HotCat/Jaguar/docs/Jaguar-SMD-Side.png

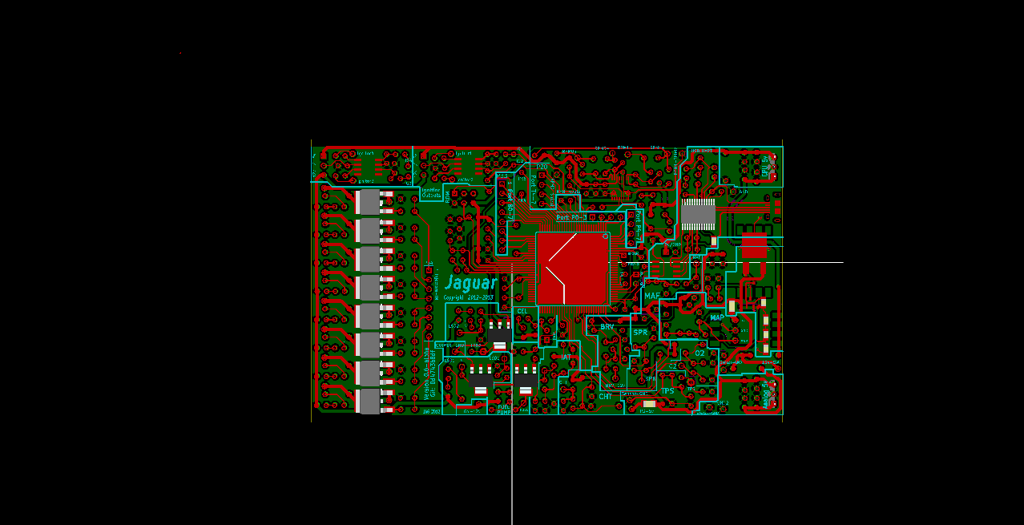
docs/Jaguar-SMD-Side.png
