HotCat/Jaguar/docs/Jaguar-TH-Side.png

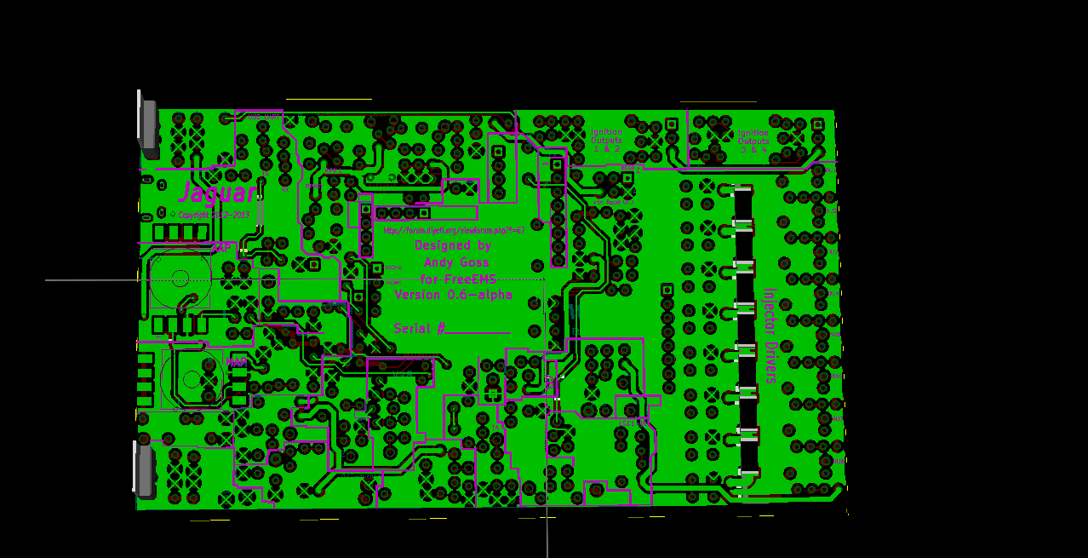
docs/Jaguar-TH-Side.png
