HotCat/Jaguar/docs/MOSFET-GND-Idea.png

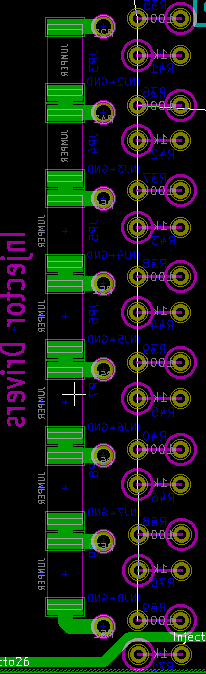
docs/MOSFET-GND-Idea.png
