HotCat/Jaguar/docs/Jaguar.ods

QTY | Reference | Value | Type | Information | To Order | CTM QTY | Manufacturer | Model# | Digikey P/N | Each | Order AMT | CTM | Note
 | Capacitors |  |  |  | 4
4 | C12,13,47,48 | 10uF | TANTALUM 10UF 35V 10% RADIAL, 0.098” LS | Tantalum | 16 | 4 | AVX Corporation | TAP106K035SCS | 478-1842-ND (http://www.digikey.com/product-detail/en/TAP106K035SCS/478-1842-ND/563945) | $1.62 | $25.92 | $6.48
13 | C1,2,3,4,5,8,20,27,37,38,44,51,55 | 0.22uF | CERAMIC 0.22UF 50V 10% RADIAL,X7R 0.098 LS | X7R | 52 | 13 | Kemet | C320C224K5R5TA | 399-4288-ND | $0.46 | $23.87 | $5.97
17 | C6,14,15,16,17,22,26,28,29,32,33,34,35,39,41,49,54 | 0.1uF / 100nF | CERAMIC 0.1UF 50V 10% RADIAL, 0.100” LS | X7R | 68 | 17 | Kemet | C320C104M1U5TA | 399-4264-ND | $0.22 | $15.23 | $3.81
1 | C7 | 6.8nF | CERAMIC 0.068UF 50V 5% RADIAL, 0.098” LS | C0G,NP0 | 4 | 1 | TDK Corportation | FK16C0G1H683J | 445-8330-ND | $0.76 | $3.04 | $0.76
1 | C9 | 680pF | CERAMIC 680PF 100V 5% RADIAL, 0.100” LS | C0G,NP0 | 4 | 1 | Kemet | C315C681J1G5TA | 399-4191-ND | $0.47 | $1.88 | $0.47
2 | C10,11 | 20pF | CERAMIC 20PF 100V 5% RADIAL, 0.100” LS | C0G,NP0 | 8 | 2 | AVX Corporation | SR151A200JAR | 478-7724-ND | $0.46 | $3.68 | $0.92
2 | C18,19 | 47uF | TANTALUM 47UF 10V 10% RADIAL, 0.100” LS | Tantalum | 8 | 2 | AVX Corporation | TAP476K010SCS | 478-1910-ND (http://search.digikey.com/us/en/products/TAP476K010SCS/478-1910-ND/564013) | $1.65 | $13.20 | $3.30
2 | C21,56 | 0.33uF | CERAMIC 0.33UF 50V 10% RADIAL, 0.100” LS | X7R | 8 | 2 | TDK Corporation | FK14X7R1H334K | 445-5312-ND (http://search.digikey.com/us/en/products/FK14X7R1H334K/445-5312-ND/2256792) | $0.38 | $3.04 | $0.76
3 | C23,42,53 | 0.01uF | CERAMIC 10000PF 50V 10% RADIAL, 0.100” LS | X7R | 12 | 3 | Kemet | C315C103K5R5TA | 399-4148-ND (http://www.digikey.com/product-detail/en/C315C103K5R5TA/399-4148-ND/817924) | $0.31 | $3.72 | $0.93
2 | C24,25 | 1nF | CERAMIC 1000PF 100V 10% RADIAL, 0.100” LS | X7R | 8 | 2 | Kemet | C315C102K1R5TA | 399-4144-ND (http://www.digikey.com/product-detail/en/C315C102K1R5TA/399-4144-ND/817920) | $0.32 | $2.56 | $0.64
6 | C30,31,36,43,52,57 | 1uF | CERAMIC 1UF 25V 10% RADIAL, 0.100” LS | X7R | 24 | 6 | Kemet | C315C105K3R5TA | 399-9714-ND | $0.79 | $18.96 | $4.74
1 | C40 | 4.7uF | TANTALUM 4.7UF 10V 10% RADIAL, 0.098” LS | Tantalum | 4 | 1 | AVX Corporation | TAP475K010SCS | 478-1903-ND (http://search.digikey.com/us/en/products/TAP475K010SCS/478-1903-ND/564006) | $0.63 | $2.52 | $0.63
 | Diodes/LEDs
1 | D1 (CEL) | LED-Yellow | LED SS 3MM 588NM YELLOW DIFF | 3mm-LED | 4 | 1 | Kingbright Corp | WP132XYD | 754-1212-ND (http://search.digikey.com/us/en/products/WP132XYD/754-1212-ND/1747611) | $0.15 | $0.60 | $0.15
1 | D2 | 5.6v 1w | DIODE ZENER 5.6V 3W AXIAL | DO-41 | 1 | 1 | ON Semiconductor | 1N5919BG | 1N5919BGOS-ND | $0.34 | $0.34 | $0.34
4 | D4,5,33,34 | LED-Green | LED SS 3MM 568NM GREEN DIFF | 3mm-LED | 16 | 4 | Kingbright Corp | WP132XGD | 754-1210-ND (http://search.digikey.com/us/en/products/WP132XGD/754-1210-ND/1747609) | $0.14 | $2.24 | $0.56
18 | D6,7,8,9,10,11,12,13,14,15,16,17,43,44,45,46,47,48 | 1N5818-TP | DIODE SCHOTTKY 1A 30V DO41 | DO-41 | 72 | 18 | Micro Commercial Co | 1N5818-TP | 1N5818-TPCT-ND (http://search.digikey.com/us/en/products/1N5818-TP/1N5818-TPCT-ND/950587) | $0.30 | $21.60 | $5.40
11 | D18,19,20,21,22,23,30,35,36,39,41 | LED-Red | LED SS 3MM 625NM RED DIFF | 3mm-LED | 44 | 11 | Kingbright Corp | WP132XID | 754-1211-ND (http://search.digikey.com/us/en/products/WP132XID/754-1211-ND/1747610) | $0.10 | $4.58 | $1.14
7 | D24,25,26,27,28,29,31,37,38,40,42 | 1N4148TA | DIODE SS FAST 100V 200MA DO35 | DO-35 | 28 | 7 | Fairchild Semiconductor | 1N4148TA | 1N4148TACT-ND (http://search.digikey.com/us/en/products/1N4148TA/1N4148TACT-ND/1532747) | $0.06 | $1.62 | $0.41
 | Connectors/Jacks
1 | J1 | USB-B micro | CONN USB MICRO B RECPT SMT R/A |  | 4 | 1 | FCI | 10118194-0001LF | 609-4618-1-ND | $0.43 | $1.73 | $0.43
1 | PLUG | TE Connectivity Plug | Automotive Connectors 35 POS AMP SEAL PLUG | Mouser | 0 | 1 | TE Connectivity/AMP | 1-776231-2 | 1-776231-2 (http://www.mouser.com/ProductDetail/TE-Connectivity-AMP/1-776231-2/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) | $14.00 | $0.00 | $14.00
1 | J3 | TE Connectivity Header | Automotive Connectors 35P AMPSEAL HDR ASSM NAT | Mouser | 0 | 1 | TE Connectivity/AMP | 1-7766163-2 | 1-776163-2 (http://www.mouser.com/ProductDetail/TE-Connectivity-AMP/1-776163-2/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) | $11.46 | $0.00 | $11.46
40 | Contacts for PLUG | TE Connectivity Contacts | Automotive Connectors AMPSEAL CONTACT | Mouser | 0 | 40 | TE Connectivity/AMP | 770854-3 | 770854-3 (http://www.mouser.com/ProductDetail/TE-Connectivity/770854-3/?qs=VZ9FDhhp7Snbed9QfbsDdg%3D%3D) | $0.68 | $0.00 | $27.20
10 | Seal Plug for Used Positions | TE Connectivity Seal Plug | AMPSEAL Accessory: SEAL PLUG | Mouser | 0 | 10 | TE Connectivity/AMP | 770678-1 | 770678-1 (http://www.mouser.com/ProductDetail/TE-Connectivity/770678-1/?qs=bVE8zYB%2Fq2c7eY42IkyCvQ%3D%3D) | $0.22 | $0.00 | $2.20
1 | MOV1 | Surge Protection | SURGE ABSORBER 14MM 22V 1000A ZNR | Disc 14mm | 4 | 1 | Panasonic - ECG | ERZ-V14D220 | P7307-ND (http://search.digikey.com/us/en/products/ERZ-V14D220/P7307-ND/227567) | $0.72 | $2.88 | $0.72
2 | F1,F2 | 8v/0.5A Polyfuse | PTC RESTTBLE 0.50A 8V CHIP 1206 | 1206 SMD | 8 | 2 | Bel Fuse Inc | 0ZCA0050FF2G | 507-1480-1-ND | $0.20 | $1.60 | $0.40
1 | L1 | 40 | Ferrite 1.5A 40 Ohm 0805 SMD | 0805 SMD | 4 | 1 | Laird-Signal Integrity Products | MI0805K400R-10 | 240-2389-1-ND | $0.10 | $0.40 | $0.10
2 | JP3,4,5,6,7,8,9 | Jumper | RES 0.0 OHM 1.5W JUMP 2512 SMD | 2512 SMD | 7 | 7 | Vishay Dale | CRCW25120000Z0EGHP | 541-0.0RBCT-ND | $1.58 | $11.07 | $3.16
 | Pin Headers
1 | Load1,P20,P21,P33,P34,JP1,JP2,JP10,JP11,JP16,PP1,PP2 | 0.100 Pin Header | CONN HEADER 50POS .100" SINGLE GOLD |  | 0 | 1 | Samtec Inc | TSW-150-07-L-S | SAM1031-50-ND (http://search.digikey.com/us/en/products/TSW-150-07-L-S/SAM1031-50-ND/1101377) | $3.11 | $0.00 | $3.11
1 | BDM 3x2 0.100” Pin Header | Two Row 0.100 Pin Header | CONN HEADER 34POS .100" DUAL GOLD |  | 0 | 1 | Samtec Inc | TSW-117-07-L-D | TSW-117-07-L-D-ND (http://search.digikey.com/us/en/products/TSW-117-07-L-D/TSW-117-07-L-D-ND/2796113) | $2.13 | $0.00 | $2.13
 | MOSFETs
8 | Q1,2,3,4,5,6,7,8 | VND7NV04 | MOSFET N-CH 40V 6A VND7NV04 60mOhm | DPAK | 0 | 8 | STMicroelectronics | VND7NV04 | 497-2669-5-ND (http://search.digikey.com/us/en/products/VND7NV04/497-2669-5-ND/603694) | $1.71 | $0.00 | $13.68
3 | Q9,10,11 | VNN7NV0413TR | MOSFET N-CH 40V 6A VNN7NV0413TR 60mOhm | SOT-223 | 0 | 3 | STMicroelectronics | VNN7NV0413TR | 497-2519-1-ND (http://search.digikey.com/us/en/products/VNN7NV0413TR/497-2519-1-ND/603901) | $1.71 | $0.00 | $5.13
1 | Q12 | KSH127TF | TRANSISTOR PNP 100V 8A DPAK | DPAK | 4 | 1 | Fairchild Semiconductor | KSH127TF | KSH127TFCT-ND | $0.61 | $2.44 | $0.61
 | Resistors
7 | R1,2,3,4,5,11,12 | 10k | RES 10.0K OHM 1/4W 1% METAL FILM |  | 28 | 7 | Yageo | MFR-25FBF-10K0 | 10.0KXBK-ND (http://search.digikey.com/us/en/products/MFR-25FBF-10K0/10.0KXBK-ND/13219) | $0.08 | $2.30 | $0.57
4 | R16,17,18,19 | 10k | RES 10.0K OHM 1/2W 1% METAL FILM | If using VR inputs | 16 | 4 | Vishay/BC Components | SFR16S0001002FR500 | PPC10.0KXCT-ND (http://search.digikey.com/us/en/products/SFR16S0001002FR500/PPC10.0KXCT-ND/594695) | $0.23 | $3.68 | $0.92 | Only purchase if using VR inputs
1 | R6 | 3.3k | RES 3.3K OHM 1/4W 0.1% AXIAL |  | 4 | 1 | Yageo | MFP-25BRD52-3K3 | 3.3KADCT-ND | $0.55 | $2.20 | $0.55
29 | R7,13,16,17,18,19,21,22,41,42,43,44,45,46,54,70,71,74,77,78,80,81,83,84,87,88,95,104,105 | 1k | RES 1.00K OHM 1/4W 1% METAL FILM |  | 116 | 29 | Yageo | MFR-25FBF-1K00 | 1.00KXBK-ND (http://search.digikey.com/us/en/products/MFR-25FBF-1K00/1.00KXBK-ND/13011) | $0.06 | $6.59 | $1.65
15 | R8,9,10,47,48,49,50,51,52,53,55,66,67,72,75 | 2.4k | RES METAL FILM 2.40K OHM 1/4W 1% |  | 60 | 15 | Stackpole Electronics Inc | RNMF14FTC2K40 | S2.4KCACT-ND (http://search.digikey.com/us/en/products/RNMF14FTC2K40/S2.4KCACT-ND/2617482) | $0.10 | $5.70 | $1.43
9 | R26,27,28,32,33,34,57,58,82 | 470 | RES METAL FILM 1/4W 470 OHM 1% AXIAL |  | 36 | 9 | Stackpole Electronics Inc | RNF14FTD470R | RNF14FTD470RCT-ND | $0.11 | $3.78 | $0.95
2 | R20,23 | 5.1k | RES 5.1K OHM 2W 5% AXIAL | Not Needed for Hall | 8 | 2 | Yageo | FMP200JR-52-5K1 | 5.1KZCT-ND | $0.20 | $1.60 | $0.40 | Only purchase if using VR inputs
3 | R24,25,31 | For GM sensors | 2.49k | RES 2.49K OHM 0.25W 0.1% METAL FILM | For GM Sensors | 12 | 3 | TT Electronics/Welwyn | RC55Y-2K49BI | 985-1047-1-ND (http://search.digikey.com/us/en/products/RC55Y-2K49BI/985-1047-1-ND/2401912) | $1.92 | $23.04 | $5.76 | Only purchase if using GM Sensors
0 | R24,25,31 | For most sensors | 2.43k | RES 2.43K OHM 0.25W 0.1% METAL FILM | For Most Sensors | 0 | 0 | TT Electronics/Welwyn | RC55Y-2K43BI | 985-1046-1-ND (http://search.digikey.com/us/en/products/RC55Y-2K43BI/985-1046-1-ND/2401911) | $1.29 | $0.00 | $0.00 | Good compromise for most Sensors
0 | R24,25,31 | For Ford sensors | 27.4k | RES 27.4K OHM 0.25W 0.1% METAL FILM AXL | For Ford Sensors | 0 | 0 | TT Electronics/Welwyn | RC55Y-27K4BI | 985-1069-1-ND (http://search.digikey.com/us/en/products/RC55Y-27K4BI/985-1069-1-ND/2401934) | $1.29 | $0.00 | $0.00 | Only purchase if using Ford Sensors
0 | R24,25,31 | For MOPAR sensors | 9.1k | RES 9.1K OHM 1/4W 0.1% METAL FILM AXL | For MOPAR Sensors | 0 | 0 | Yageo | MFP-25BRD52-9K1 | 9.1KADCT-ND (http://search.digikey.com/us/en/products/MFP-25BRD52-9K1/9.1KADCT-ND/2059152) | $0.44 | $0.00 | $0.00 | Only purchase if using Mopar Sensors
1 | R29 | 3.9k | RES 3.9K OHM 1/4W 0.1% METAL FILM AXL |  | 4 | 1 | Yageo | MFP-25BRD52-3K9 | 3.9KADCT-ND (http://search.digikey.com/us/en/products/MFP-25BRD52-3K9/3.9KADCT-ND/2059137) | $0.55 | $2.20 | $0.55
1 | R30 | 1.0k | RES 1K OHM 1/4W 0.1% METAL FILM AXL |  | 4 | 1 | Yageo | MFP-25BRD52-1K | 1KADCT-ND (http://search.digikey.com/us/en/products/MFP-25BRD52-1K/1KADCT-ND/2059121) | $0.55 | $2.20 | $0.55
15 | R35,36,37,38,39,40,63,68,69,73,76,89,90,102,103 | 100k | RES 100K OHM 1/4W 1% METAL FILM |  | 60 | 15 | Yageo | MFR-25FBF-100K | 100KXBK-ND (http://search.digikey.com/us/en/products/MFR-25FBF-100K/100KXBK-ND/13473) | $0.06 | $3.41 | $0.85
4 | R91,92,100,101 | 160 | RES 160 OHM 2W 1% AXIAL |  | 16 | 4 | Yageo | FMP200FRF52-160R | 160YCT-ND | $0.27 | $4.32 | $1.08
2 | R106,107 | 10k | RES 10K OHM 1/8W 0.1% 0805 SMD | 0805 SMD | 8 | 2 | Bourns Inc | CRT0805-BY-1002ELF | CRT0805-BY-1002ELFCT-ND | $0.51 | $4.08 | $1.02
1 | R108 | 330 | RES 330 OHM 1/8W 0.1% 0805 SMD | 0805 SMD | 4 | 1 | Panasonic Electronic Components | ERA-6AEB331V | P330DACT-ND | $0.63 | $2.52 | $0.63
1 | R109 | 604 | RES 604 OHM 1/8W 0.1% 0805 SMD | 0805 SMD | 4 | 1 | Panasonic Electronic Components | ERA-6AEB6040V | P604DACT-ND | $0.63 | $2.52 | $0.63
 | ICs
1 | U1 | MC9S12XDP512 | IC MCU 512K FLASH 112-LQFP MC9S12XDP512MAL | LQFP-112 |  | 1 | Freescale Semiconductor | MC9S12XDP512MAL | MC9S12XDP512MAL-ND (http://search.digikey.com/us/en/products/MC9S12XDP512MAL/MC9S12XDP512MAL-ND/1167902) | $23.53 | $0.00 | $23.53
2 | U2,3 | LM2940T-5.0/NOPB | IC REGULATOR LDO LM2940-5.0 1A TO220 | TO-220 | 8 | 2 | Texas Instruments | LM2940T-5.0/NOPB | LM2940T-5.0/NOPB | $1.68 | $13.44 | $3.36
2 | U2,3 | SP900S-0.009-AC-54 | SILICONE THERMAL PAD TO-220 W/ADH .009" SP9 |  | 8 | 2 | Bergquist | SP900S-0.009-AC-54 | BER182-ND | $0.18 | $1.44 | $0.36
2 | U2,3 | 7721-7PPSG | INSULATING SHOULDER WASHER |  | 8 | 2 | Aavid Thermalloy | 7721-7PPSG | HS418-ND | $0.23 | $1.84 | $0.46
2 | U2,3 | 4724 | MICA PAD AND HARDWARE MOUNTING KIT FOR TO-220 |  | 8 | 2 | Keystone Electronics | 4724 | 4724K-ND | $1.94 | $15.52 | $3.88
1 | U4 | MAX9926UAEE+ | IC SENSOR INTERFACE VARI 16-QSOP | 16-QSOP | 4 | 1 | Maxim Integrated Products | MAX9926UAEE+ | MAX9926UAEE+-ND (http://search.digikey.com/us/en/products/MAX9926UAEE%2B/MAX9926UAEE%2B-ND/2062014) | $3.59 | $14.36 | $3.59
1 | U6 | MPXA4250AC6U | PRESSURE SENS 36.3PSI MAX 8-SOP | 8-SOIC | 0 | 1 | Freescale Semiconductor | MPXA4250AC6U | MPXA4250AC6U-ND | $16.37 | $0.00 | $16.37
1 | U7 | FT232RL | IC FT232RL USB FS SERIAL UART 28-SSOP | 28-SSOP | 4 | 1 | FTDI, Future Technology Devices International Ltd | FT232RL-REEL | 768-1007-1-ND (http://search.digikey.com/us/en/products/FT232RL-REEL/768-1007-1-ND/1836402) | $4.50 | $18.00 | $4.50
1 | U8 | ADUM3201BRZ | ISOLATOR DGTL 10MBPS 2CH 8SOIC | 8-SOIC | 4 | 1 | Analog Devices | ADUM3201BRZ | ADUM3201BRZ-ND | $3.63 | $14.52 | $3.63
2 | U9,12 | TC4427AEOA | IC MOSFET DVR 1.5A DUAL HS 8SOIC | 8-SOIC | 8 | 2 | Microchip Technology | TC4427AEOA | TC4427AEOA-ND | $1.24 | $9.92 | $2.48
1 | U11 | MPXA6115AC6U | PRESSURE SENS 16.7PSI MAX 8-SOP |  | 0 | 1 | Freescale Semiconductor | MPXA6115AC6U | MPXA6115AC6U-ND | $12.55 | $0.00 | $12.55
1 | U13 | TL431BQDBZR | IC VREF SHUNT PREC ADJ SOT-23-3 | SOT-23-3 | 4 | 1 | Texas Instruments | TL431BQDBZR | 296-17623-1-ND | $0.72 | $2.88 | $0.72
 | Crystal
1 | X1 | 16.0MHz | CRYSTAL 16.000 MHZ 20PF 49US -40C to 85C | HC-49US | 4 | 1 | ECS Inc | ECS-160-20-4DN | X192-ND (http://search.digikey.com/us/en/products/ECS-160-20-4DN/X192-ND/281763) | $1.12 | $4.48 | $1.12 | Recommended for current design
 |  |  |  |  |  |  |  | Cost To Manufacture (CTM) |  | US Dollars |  | $214.70 | Not including shipping or sales tax
1 | Case |  | 3.12”x5.00”x1.85” Extruded Aluminum Split Body Case |  |  | 1 | Context Engineering Company | 3008H-5B (plain ends) or 3008F-5N (flanged ends) | http://store01.prostores.com/servlet/thescienceshop/the-2220/5.0%22-L-x-3.12%22/Detail | $14.99 | $0.00 | $14.99
 | Printed Circuit Board
1 | Jaguar PCB | Estimate ONLY |  |  |  | 1 | N/A | N/A |  | $8.19 | $0.00 | $8.19 | 10 Prototype boards cost $81.90
 |  |  |  |  |  |  |  | Total of Materials:Cost to Manufacture |  | US Dollars |  | $237.88 | Not including shipping or sales tax
 |  |  |  |  |  |  |  |  | Order Total |  | $335.25
 |  |  |  |  |  |  |  |  |  |  |  | 278
