HotCat/Jaguar/pcb/Injectors.sch

## KiCad design pcb/Injectors.sch (2013-09-18)

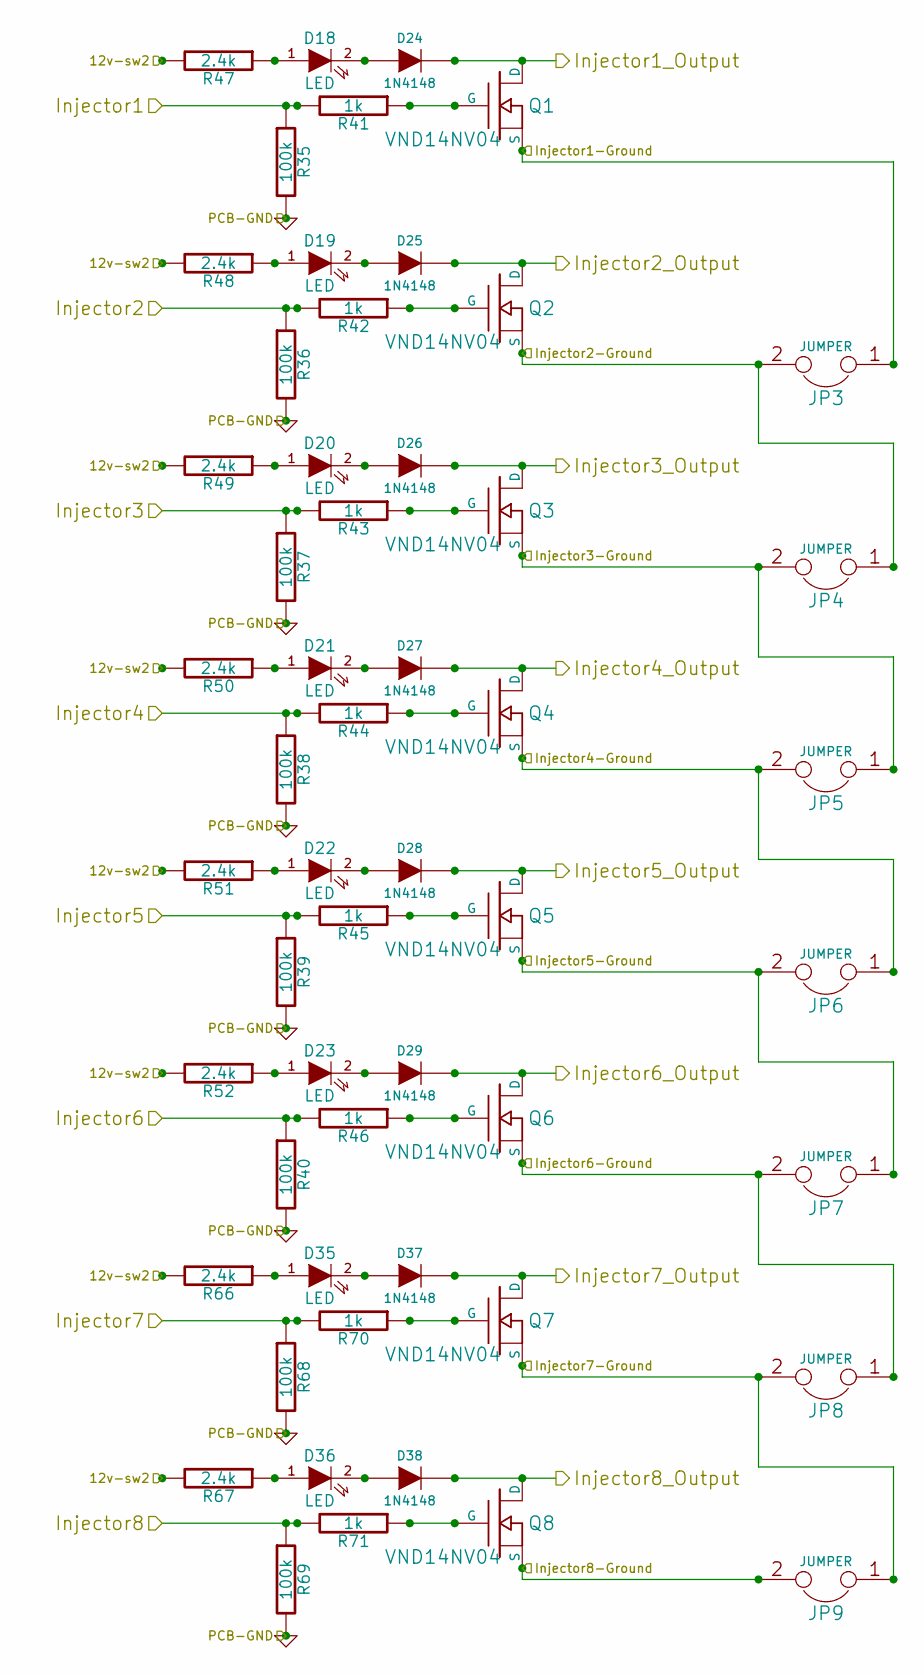
[picture p17: schematic Injectors.sch]

Parts:
D18, D19, D20, D21, D22, D23, D35, D36: LED
D24, D25, D26, D27, D28, D29, D37, D38: 1N4148
JP3, JP4, JP5, JP6, JP7, JP8, JP9: JUMPER
Q1, Q2, Q3, Q4, Q5, Q6, Q7, Q8: VND14NV04
R35, R36, R37, R38, R39, R40, R68, R69: 100k
R41, R42, R43, R44, R45, R46, R70, R71: 1k; Digikey 1.00KXBK-ND
R47, R48, R49, R50, R51, R52, R66, R67: 2.4k

Connections:
12v-sw2: R47.2, R48.2, R49.2, R50.2, R51.2, R52.2, R66.2, R67.2
GND: R35.2, R36.2, R37.2, R38.2, R39.2, R40.2, R68.2, R69.2
Injector1: R35.1, R41.2
Injector1-Ground: JP3.1, Q1.S
Injector1_Output: D24.2 (K), Q1.D
Injector2: R36.1, R42.2
Injector2-Ground: JP3.2, JP4.1, Q2.S
Injector2_Output: D25.2 (K), Q2.D
Injector3: R37.1, R43.2
Injector3-Ground: JP4.2, JP5.1, Q3.S
Injector3_Output: D26.2 (K), Q3.D
Injector4: R38.1, R44.2
Injector4-Ground: JP5.2, JP6.1, Q4.S
Injector4_Output: D27.2 (K), Q4.D
Injector5: R39.1, R45.2
Injector5-Ground: JP6.2, JP7.1, Q5.S
Injector5_Output: D28.2 (K), Q5.D
Injector6: R40.1, R46.2
Injector6-Ground: JP7.2, JP8.1, Q6.S
Injector6_Output: D29.2 (K), Q6.D
Injector7: R68.1, R70.2
Injector7-Ground: JP8.2, JP9.1, Q7.S
Injector7_Output: D37.2 (K), Q7.D
Injector8: R69.1, R71.2
Injector8-Ground: JP9.2, Q8.S
Injector8_Output: D38.2 (K), Q8.D
unnamed: D18.1 (A), R47.1
unnamed: D18.2 (K), D24.1 (A)
unnamed: D19.1 (A), R48.1
unnamed: D19.2 (K), D25.1 (A)
unnamed: D20.1 (A), R49.1
unnamed: D20.2 (K), D26.1 (A)
unnamed: D21.1 (A), R50.1
unnamed: D21.2 (K), D27.1 (A)
unnamed: D22.1 (A), R51.1
unnamed: D22.2 (K), D28.1 (A)
unnamed: D23.1 (A), R52.1
unnamed: D23.2 (K), D29.1 (A)
unnamed: D35.1 (A), R66.1
unnamed: D35.2 (K), D37.1 (A)
unnamed: D36.1 (A), R67.1
unnamed: D36.2 (K), D38.1 (A)
unnamed: Q1.G, R41.1
unnamed: Q2.G, R42.1
unnamed: Q3.G, R43.1
unnamed: Q4.G, R44.1
unnamed: Q5.G, R45.1
unnamed: Q6.G, R46.1
unnamed: Q7.G, R70.1
unnamed: Q8.G, R71.1
