HotCat/Jaguar/pcb/Jaguar.sch

## KiCad design pcb/Jaguar.sch (2013-09-18)

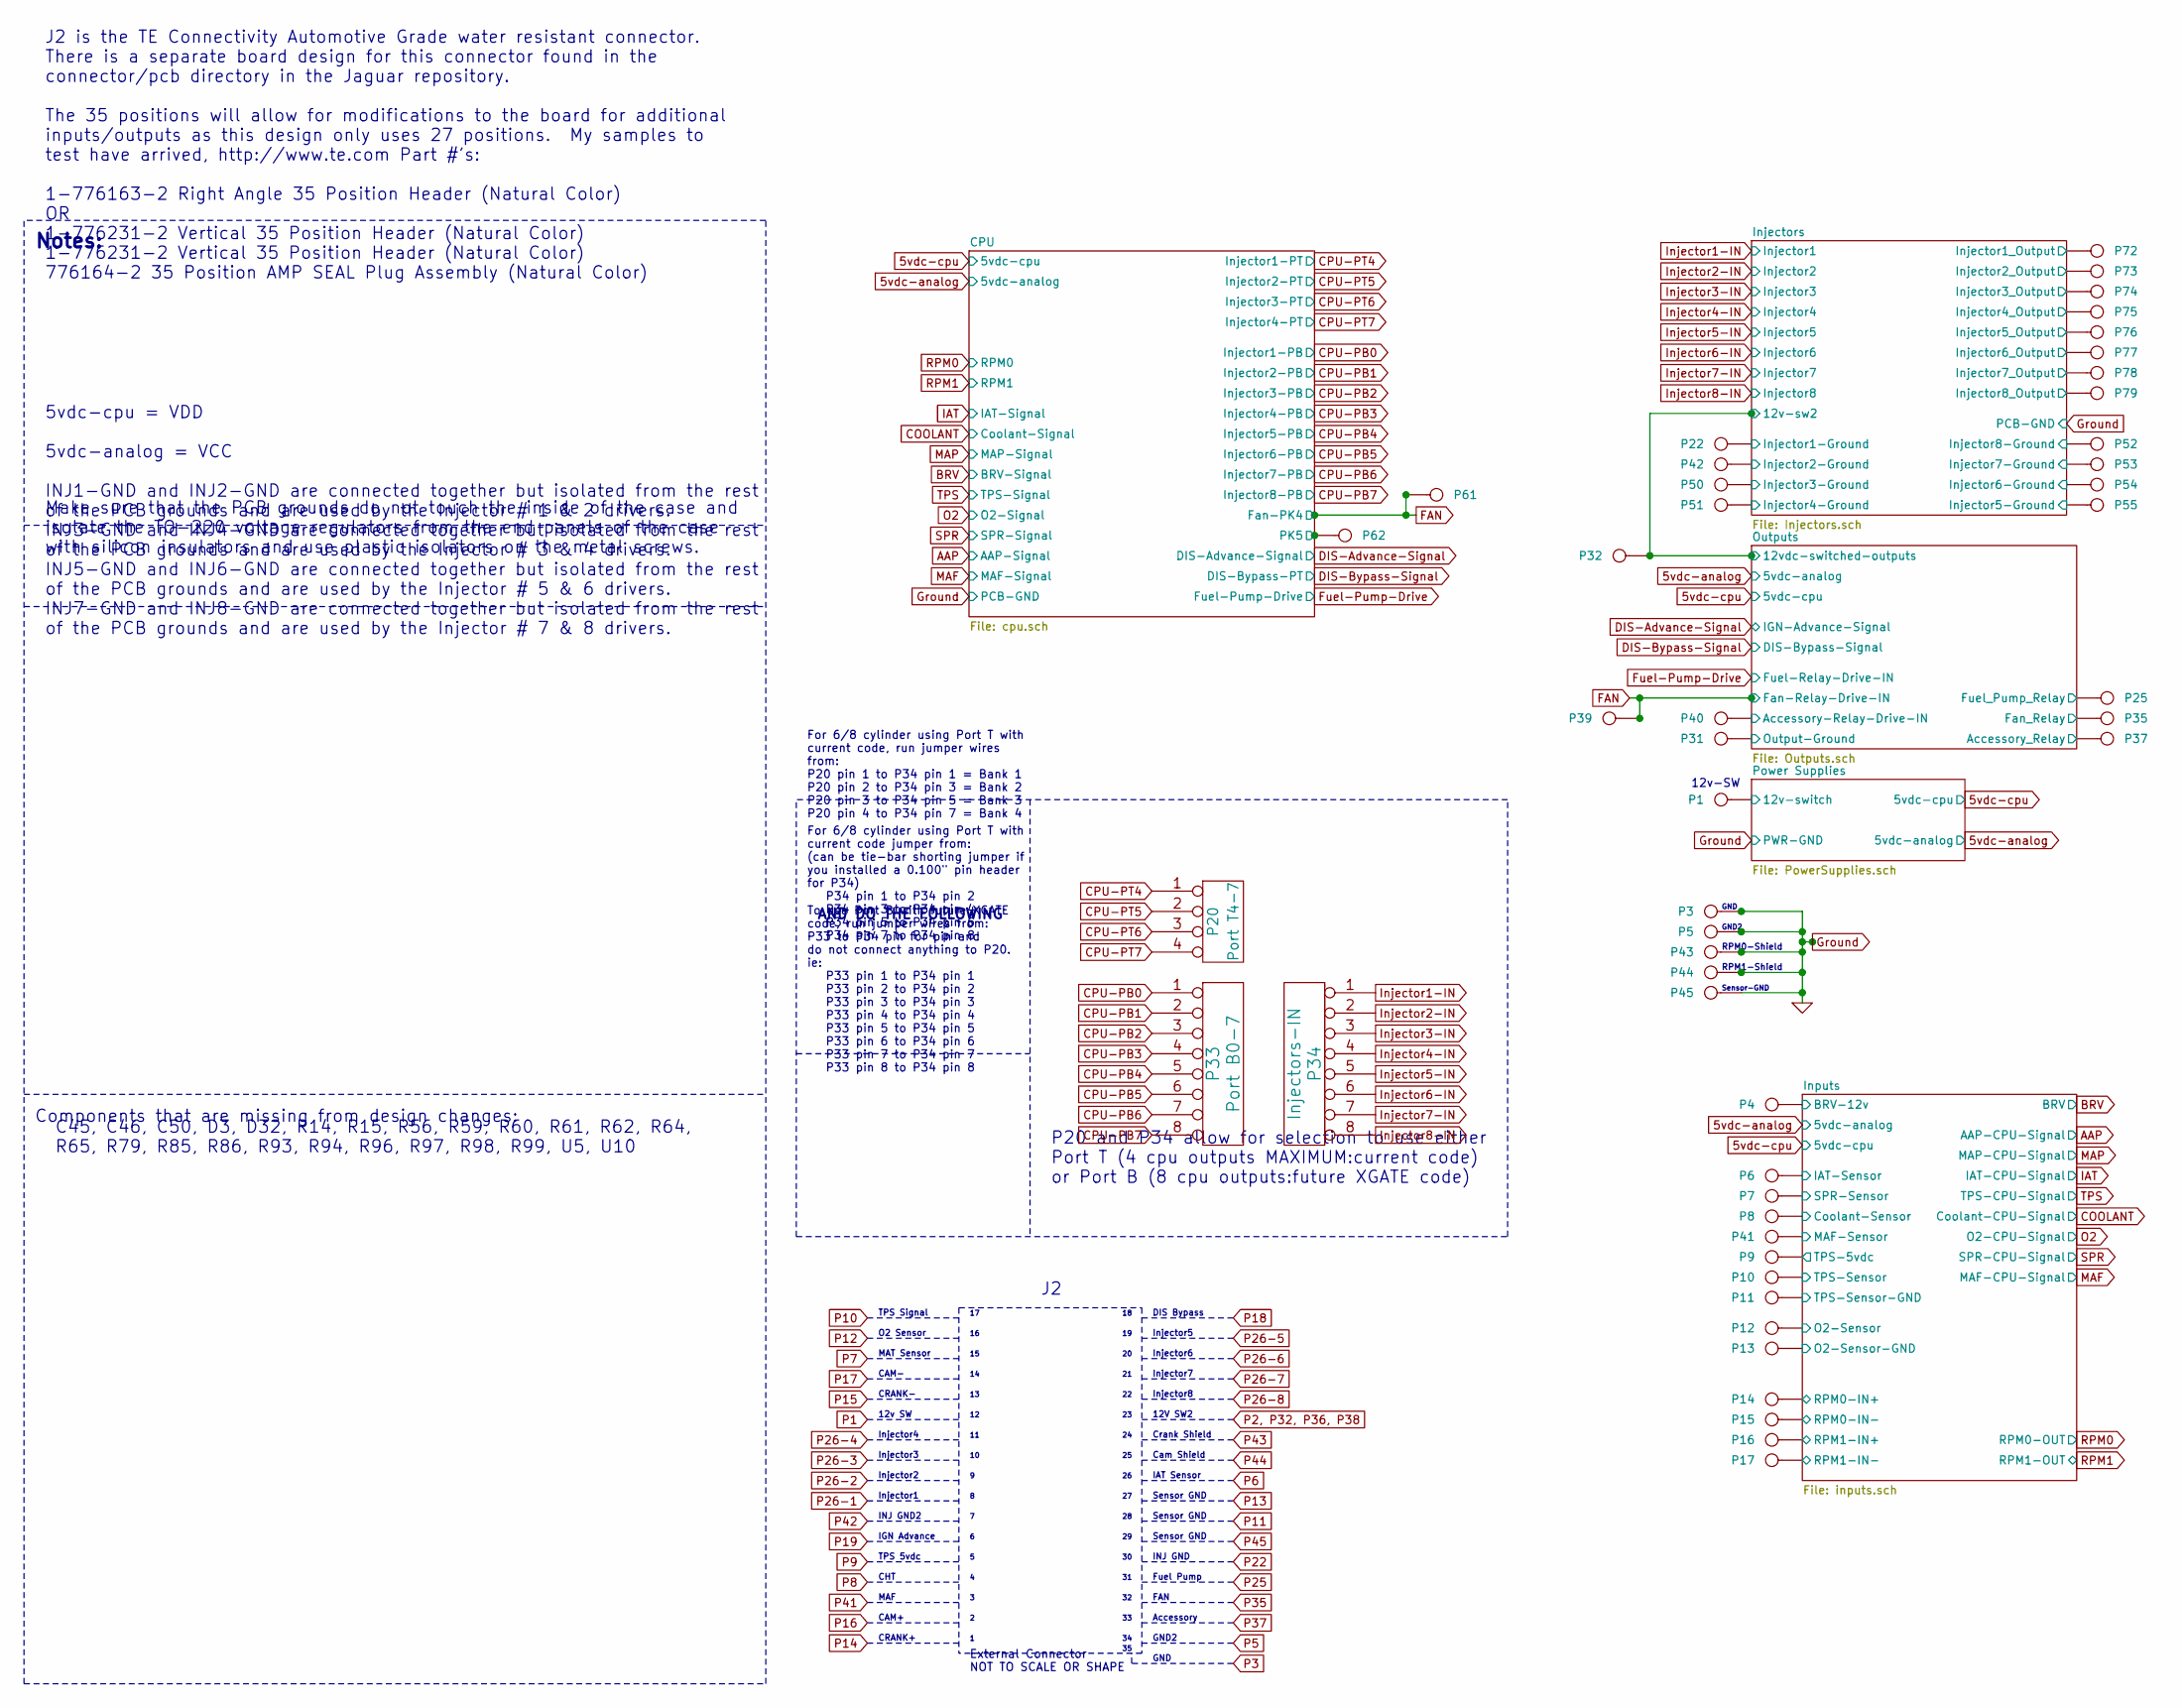
[picture p18: schematic Jaguar.sch]

Parts:
P1: 12v-SW
P3: GND
P4: BRV-12v
P5: GND2
P6: IAT
P7: SPR
P8: CHT
P9: TPS-5v
P10: TPS
P11, P13, P45: Sensor-GND
P12: O2
P14: RPM0+
P15: RPM0-
P16: RPM1+
P17: RPM1-
P20: Port T4-7
P22: INJ1-GND
P25: FUEL
P31: OUT-GND
P32: IGN-12v
P33: Port B0-7
P34: Injectors-IN
P35: LSD1
P37: LSD2
P39: LSD1-IN
P40: LSD2-IN
P41: MAF
P42: INJ2-GND
P43: RPM0-Shield
P44: RPM1-Shield
P50: INJ3-GND
P51: INJ4-GND
P52: INJ8-GND
P53: INJ7-GND
P54: INJ6-GND
P55: INJ5-GND
P61: LSD1-Out
P62: PortK5
P72: INJ1
P73: INJ2
P74: INJ3
P75: INJ4
P76: INJ5
P77: INJ6
P78: INJ7
P79: INJ8

Connections:
12v-switch: P1.1
12vdc-switched-outputs: P32.1
Accessory-Relay-Drive-IN: P40.1
Accessory_Relay: P37.1
BRV-12v: P4.1
CPU-PB0: P33.1
CPU-PB1: P33.2
CPU-PB2: P33.3
CPU-PB3: P33.4
CPU-PB4: P33.5
CPU-PB5: P33.6
CPU-PB6: P33.7
CPU-PB7: P33.8
CPU-PT4: P20.1
CPU-PT5: P20.2
CPU-PT6: P20.3
CPU-PT7: P20.4
Coolant-Sensor: P8.1
FAN: P39.1, P61.1
Fan_Relay: P35.1
Fuel_Pump_Relay: P25.1
GND: P3.1, P5.1, P43.1, P44.1, P45.1
IAT-Sensor: P6.1
Injector1-Ground: P22.1
Injector1-IN: P34.1
Injector1_Output: P72.1
Injector2-Ground: P42.1
Injector2-IN: P34.2
Injector2_Output: P73.1
Injector3-Ground: P50.1
Injector3-IN: P34.3
Injector3_Output: P74.1
Injector4-Ground: P51.1
Injector4-IN: P34.4
Injector4_Output: P75.1
Injector5-Ground: P55.1
Injector5-IN: P34.5
Injector5_Output: P76.1
Injector6-Ground: P54.1
Injector6-IN: P34.6
Injector6_Output: P77.1
Injector7-Ground: P53.1
Injector7-IN: P34.7
Injector7_Output: P78.1
Injector8-Ground: P52.1
Injector8-IN: P34.8
Injector8_Output: P79.1
MAF-Sensor: P41.1
O2-Sensor: P12.1
O2-Sensor-GND: P13.1
Output-Ground: P31.1
PK5: P62.1
RPM0-IN+: P14.1
RPM0-IN-: P15.1
RPM1-IN+: P16.1
RPM1-IN-: P17.1
SPR-Sensor: P7.1
TPS-5vdc: P9.1
TPS-Sensor: P10.1
TPS-Sensor-GND: P11.1

Notes on the sheet:
C45, C46, C50, D3, D32, R14, R15, R56, R59, R60, R61, R62, R64, R65, R79, R85, R86, R93, R94, R96, R97, R98, R99, U5, U10
Components that are missing from design changes:
Sensor-GND
12v-SW
5vdc-cpu = VDD 5vdc-analog = VCC INJ1-GND and INJ2-GND are connected together but isolated from the rest of the PCB grounds and are used by the Injector # 1 & 2 drivers. INJ3-GND and INJ4-GND are connected together but isolated from the rest of the PCB grounds and are used by the Injector # 3 & 4 d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
RPM1-Shield
RPM0-Shield
INJ GND2
Sensor GND
FAN
Accessory
MAF
Cam Shield
Crank Shield
Injector8
Injector7
GND2
GND
Make sure that the PCB grounds do not touch the inside of the case and isolate the TO-220 voltage regulators from the end panels of the case with silicon insulators and use plastic isolators on the metal screws.
AND DO THE FOLLOWING
Fuel Pump
DIS Bypass
IGN Advance
INJ GND
Injector1
Injector2
Injector3
Injector4
Injector5
Injector6
12v SW
12V SW2
CRANK+
CRANK-
CAM+
CAM-
IAT Sensor
MAT Sensor
CHT
O2 Sensor
TPS 5vdc
TPS Signal
To use Port B with future XGATE code, run jumper wires from: P33 to P34 pin for pin and do not connect anything to P20. ie: P33 pin 1 to P34 pin 1 P33 pin 2 to P34 pin 2 P33 pin 3 to P34 pin 3 P33 pin 4 to P34 pin 4 P33 pin 5 to P34 pin 5 P33 pin 6 to P34 pin 6 P33 pin 7 to P34 pin 7 P33 pin 8 to P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
For 6/8 cylinder using Port T with current code jumper from: (can be tie-bar shorting jumper if you installed a 0.100" pin header for P34) P34 pin 1 to P34 pin 2 P34 pin 3 to P34 pin 4 P34 pin 5 to P34 pin 6 P34 pin 7 to P34 pin 8
For 6/8 cylinder using Port T with current code, run jumper wires from: P20 pin 1 to P34 pin 1 = Bank 1 P20 pin 2 to P34 pin 3 = Bank 2 P20 pin 3 to P34 pin 5 = Bank 3 P20 pin 4 to P34 pin 7 = Bank 4
P20 and P34 allow for selection to use either Port T (4 cpu outputs MAXIMUM:current code) or Port B (8 cpu outputs:future XGATE code)
J2 is the TE Connectivity Automotive Grade water resistant connector. There is a separate board design for this connector found in the connector/pcb directory in the Jaguar repository. The 35 positions will allow for modifications to the board for additional inputs/outputs as this design only uses 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
Notes:
External Connector NOT TO SCALE OR SHAPE
