HotCat/Jaguar/pcb/Outputs.sch

## KiCad design pcb/Outputs.sch (2013-09-18)

Schematic: Outputs.sch

Parts:
C52, C57: 1uF
D30, D39, D41: LED
D31, D40, D42: 1N4148
JP1, JP2: 5v/12v
P66: IG2
P67: IG1
P81: IG3
P82: IG4
P84: Ignitor2
P85: Ignitor1
P86: Ignitor3
P87: Ignitor4
Q9, Q10, Q11: VNN7NV0413TR
R53, R72, R75: 2.4k
R54, R74, R77, R87, R88, R104, R105: 1k
R63, R73, R76, R89, R90, R102, R103: 100k
R91, R92, R100, R101: 160
U9, U12: TC442XA

Notes on the sheet:
TC4426A has two inverting drivers, while the TC4427A has two non-inverting drivers, The TC4428A has one inverting and one non-inverting driver.
Ignitor Outputs
JP2 selects either 5v or 12v Driver IC Supply
JP1 selects either 5v or 12v Driver IC Supply
Low Side Driver #2 Output
Low Side Driver #1 Output
Fuel Pump Relay Output
