HotCat/Jaguar/pcb/PowerSupplies.sch

## KiCad design pcb/PowerSupplies.sch (2013-09-18)

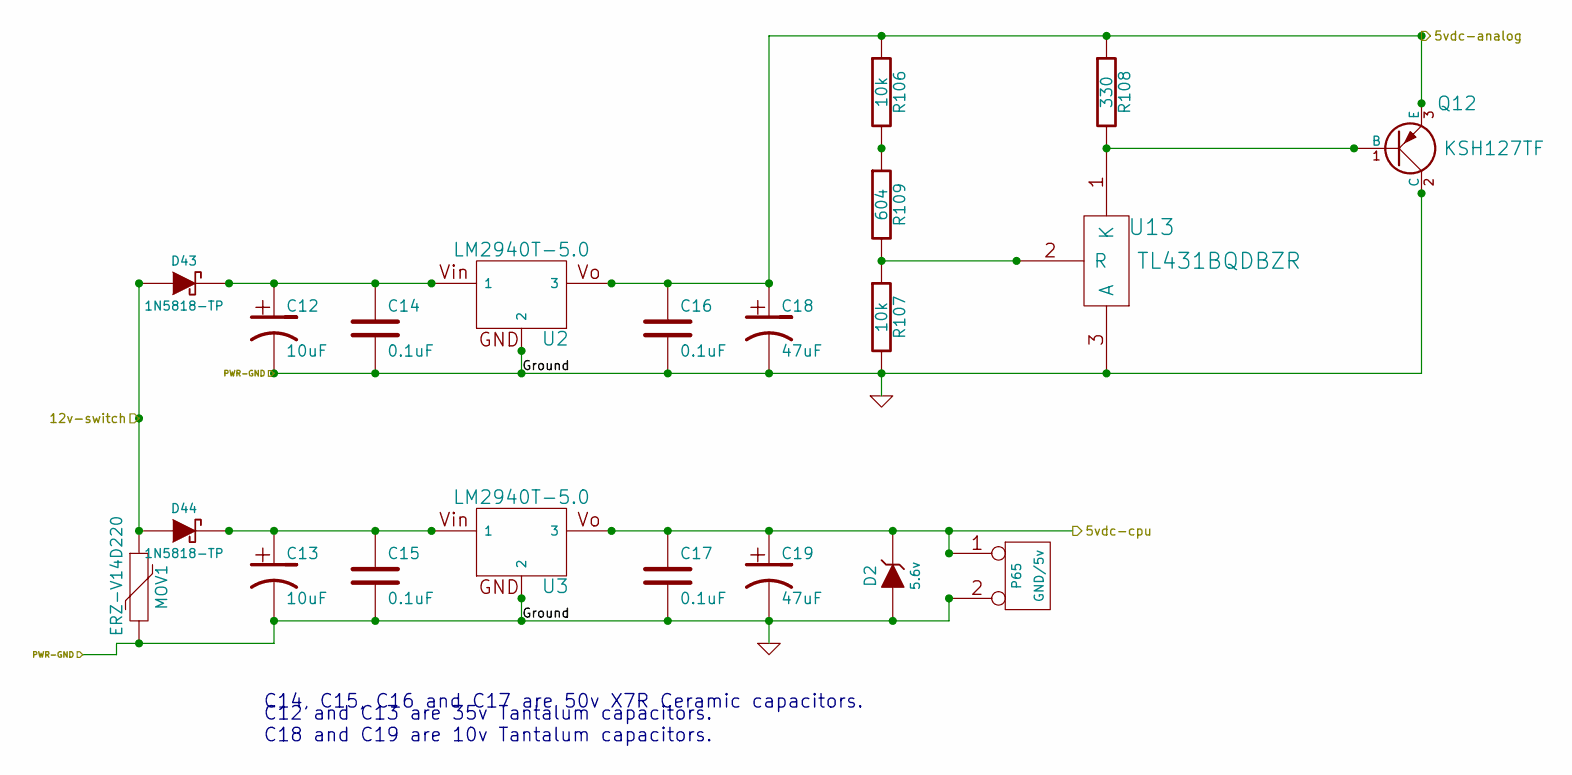
[picture p19: schematic PowerSupplies.sch]

Parts:
C12, C13: 10uF
C14, C15, C16, C17: 0.1uF
C18, C19: 47uF
D2: 5.6v
D43, D44: 1N5818-TP
MOV1: ERZ-V14D220
P65: GND/5v
Q12: KSH127TF
R106, R107: 10k
R108: 330
R109: 604
U2, U3: LM2940T-5.0
U13: TL431BQDBZR

Connections:
5vdc-analog: C16.1, C18.1 (+), Q12.3 (E), R106.1, R108.1, U2.3
5vdc-cpu: C17.1, C19.1 (+), D2.2 (K), P65.1, U3.3
12v-switch: D43.1 (A), D44.1 (A), MOV1.1
GND: C12.2 (-), C13.2 (-), C14.2, C15.2, C16.2, C17.2, C18.2 (-), C19.2 (-), D2.1 (A), MOV1.2, P65.2 (PM), Q12.2 (C), R107.2, U2.2, U3.2, U13.3 (A)
unnamed: C12.1 (+), C14.1, D43.2 (K), U2.1
unnamed: C13.1 (+), C15.1, D44.2 (K), U3.1
unnamed: Q12.1 (B), R108.2, U13.1 (K)
unnamed: R106.2, R109.1
unnamed: R107.1, R109.2, U13.2 (R)

Notes on the sheet:
C14, C15, C16 and C17 are 50v X7R Ceramic capacitors.
C12 and C13 are 35v Tantalum capacitors. C18 and C19 are 10v Tantalum capacitors.
