HotCat/Jaguar/pcb/cpu.sch

## KiCad design pcb/cpu.sch (2013-09-18)

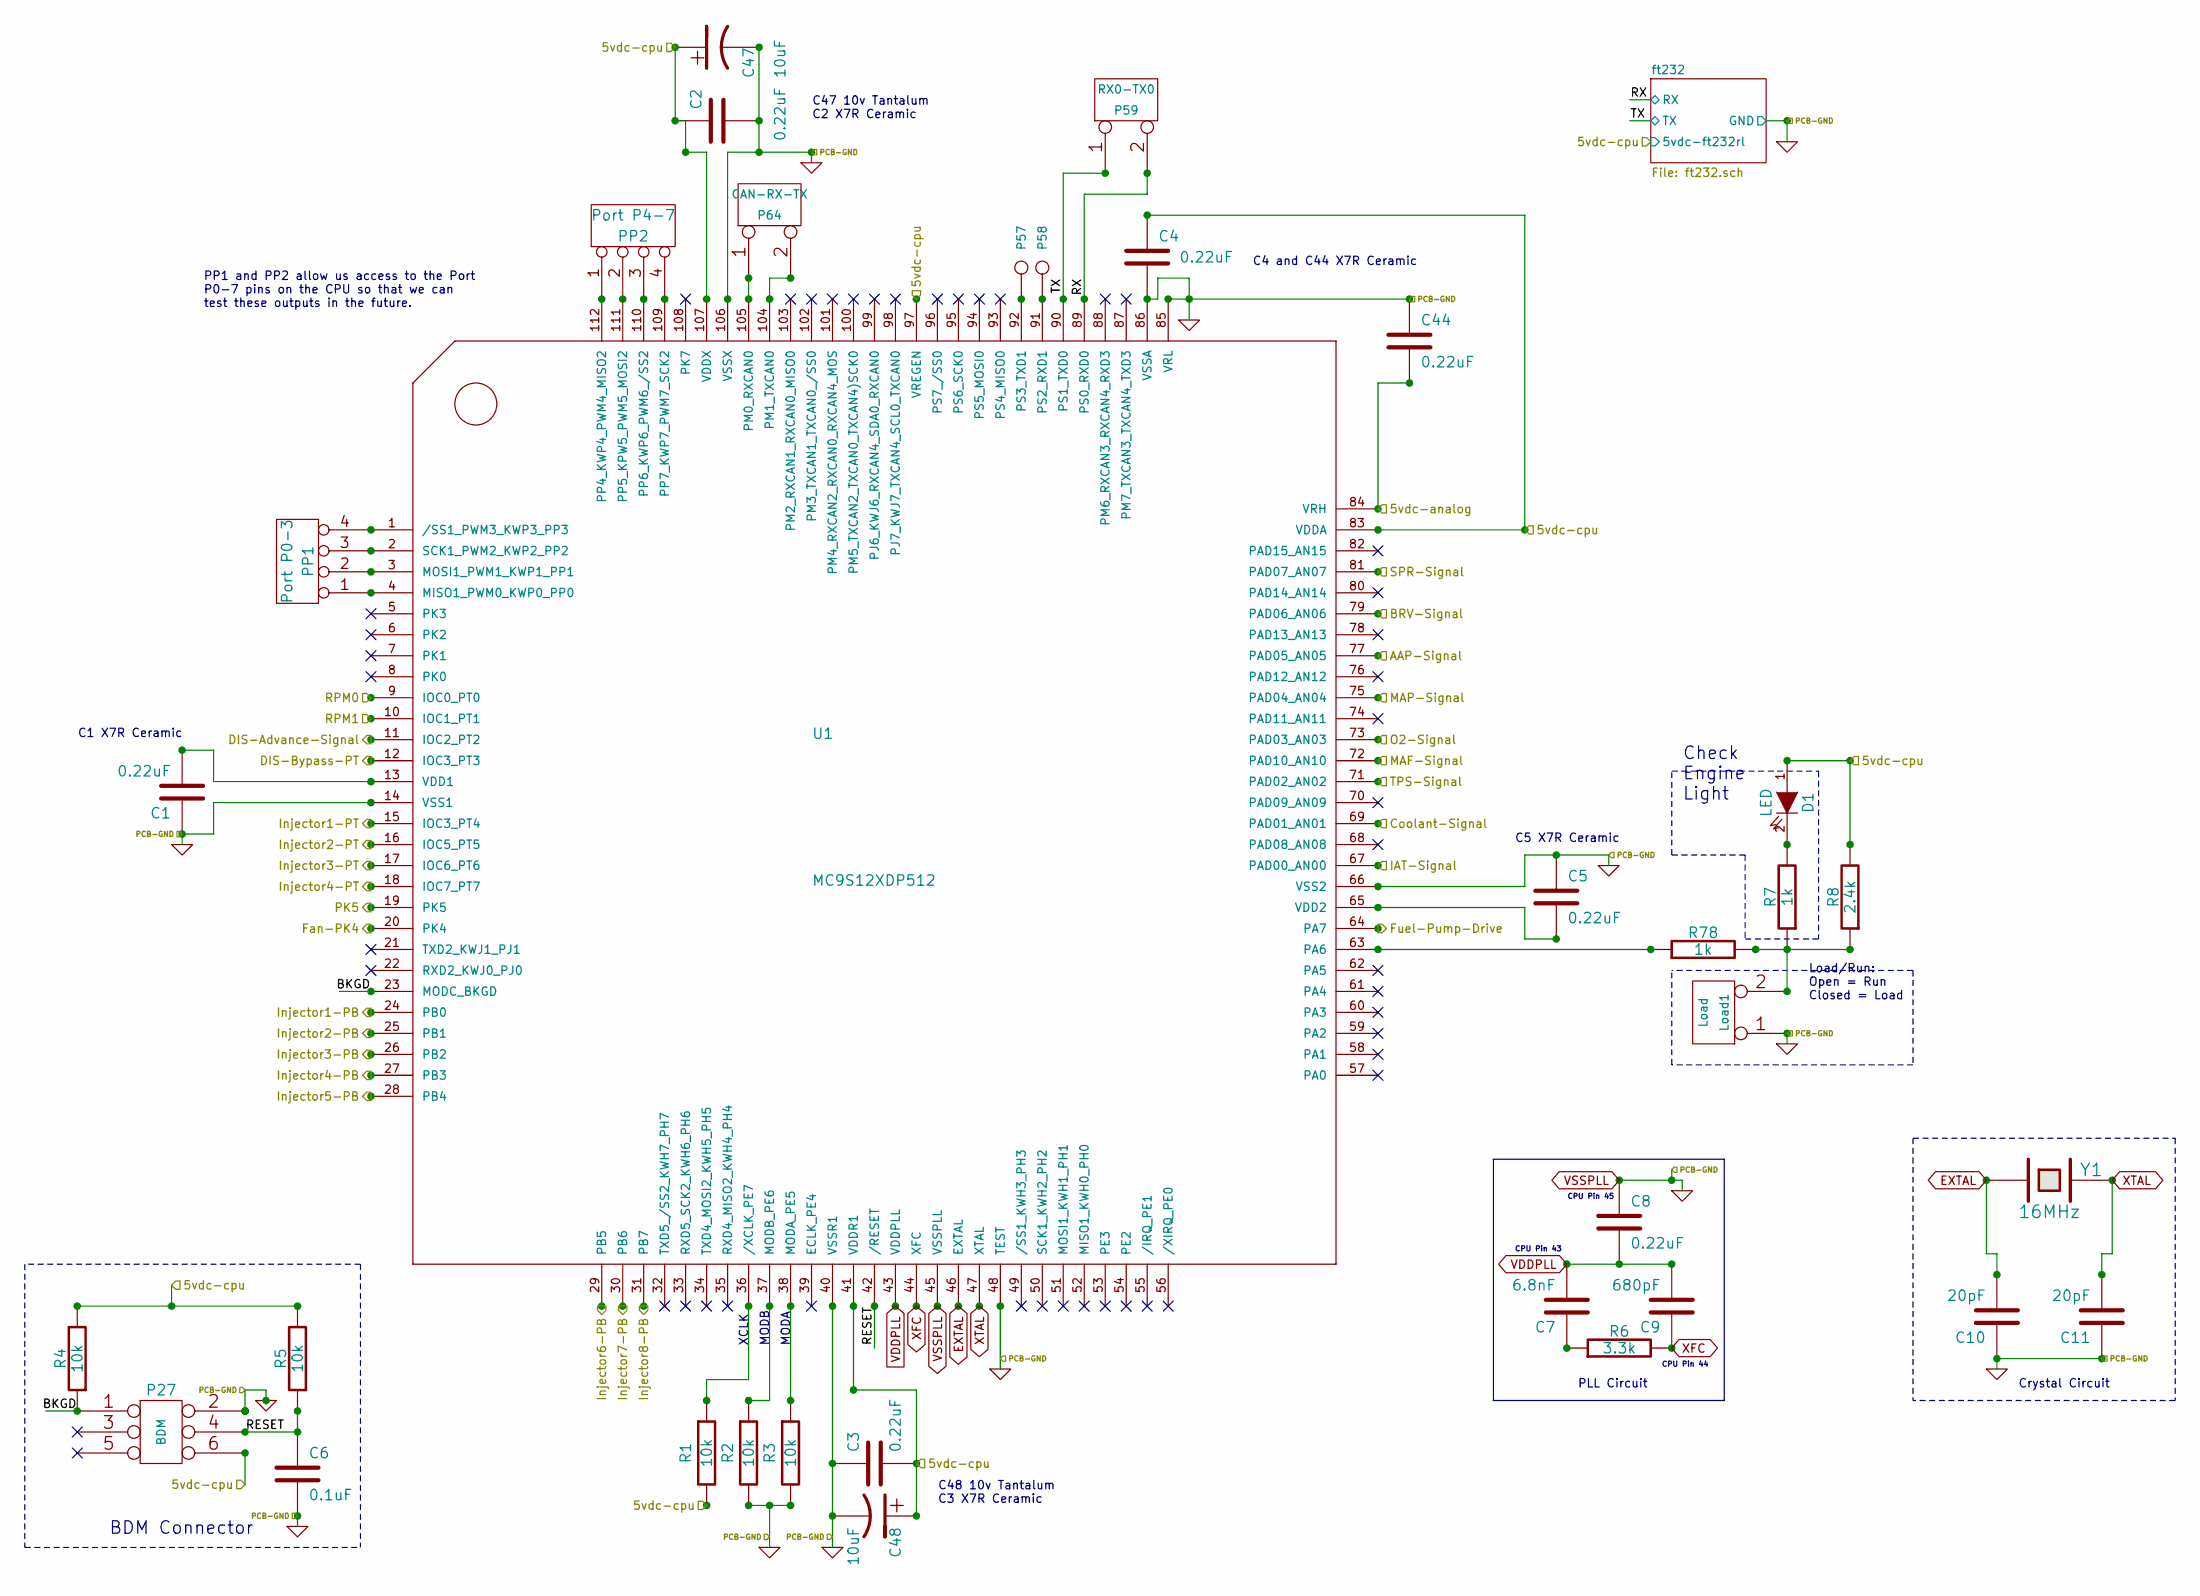
[picture p20: schematic cpu.sch]

Parts:
C1, C2, C3, C4, C5, C8, C44: 0.22uF
C6: 0.1uF
C7: 6.8nF
C9: 680pF
C10, C11: 20pF
C47, C48: 10uF
D1: LED
Load1: Load
P27: BDM
P57: TX1
P58: RX1
P59: RX0-TX0
P64: CAN-RX-TX
PP1: Port P0-3
PP2: Port P4-7
R1, R2, R3, R4, R5: 10k
R6: 3.3k
R7, R78: 1k
R8: 2.4k
U1: MC9S12XDP512; mc9s12xdp512-LQFP112
Y1: 16MHz

Connections:
5vdc-analog: C44.2, U1.84 (VRH)
5vdc-cpu: C2.1, C3.2, C4.1, C47.1 (+), C48.1 (+), D1.1 (A), P27.6, R1.2, R4.2, R5.2, R8.2, U1.41 (VDDR1), U1.83 (VDDA), U1.97 (VREGEN), U1.107 (VDDX)
AAP-Signal: U1.77 (PAD05_AN05)
BKGD: P27.1, R4.1, U1.23 (MODC_BKGD)
BRV-Signal: U1.79 (PAD06_AN06)
Coolant-Signal: U1.69 (PAD01_AN01)
DIS-Advance-Signal: U1.11 (IOC2_PT2)
DIS-Bypass-PT: U1.12 (IOC3_PT3)
EXTAL: C10.2, U1.46 (EXTAL), Y1.1
Fan-PK4: U1.20 (PK4)
Fuel-Pump-Drive: U1.64 (PA7)
GND: C1.1, C2.2, C3.1, C4.2, C5.1, C6.2, C8.1, C10.1, C11.1, C44.1, C47.2 (-), C48.2 (-), Load1.1, P27.2, R2.2, R3.2, U1.14 (VSS1), U1.40 (VSSR1), U1.45 (VSSPLL), U1.48 (TEST), U1.66 (VSS2), U1.85 (VRL), U1.86 (VSSA), U1.106 (VSSX)
IAT-Signal: U1.67 (PAD00_AN00)
Injector1-PB: U1.24 (PB0)
Injector1-PT: U1.15 (IOC3_PT4)
Injector2-PB: U1.25 (PB1)
Injector2-PT: U1.16 (IOC5_PT5)
Injector3-PB: U1.26 (PB2)
Injector3-PT: U1.17 (IOC6_PT6)
Injector4-PB: U1.27 (PB3)
Injector4-PT: U1.18 (IOC7_PT7)
Injector5-PB: U1.28 (PB4)
Injector6-PB: U1.29 (PB5)
Injector7-PB: U1.30 (PB6)
Injector8-PB: U1.31 (PB7)
MAF-Signal: U1.72 (PAD10_AN10)
MAP-Signal: U1.75 (PAD04_AN04)
unnamed: C1.2, U1.13 (VDD1)
unnamed: C5.2, U1.65 (VDD2)
unnamed: C7.1, R6.1
unnamed: D1.2 (K), R7.2
unnamed: Load1.2 (PM), R7.1, R8.1, R78.2
unnamed: P57.1, U1.92 (PS3_TXD1)
unnamed: P58.1, U1.91 (PS2_RXD1)
unnamed: P64.1, U1.105 (PM0_RXCAN0)
unnamed: P64.2 (PM), U1.104 (PM1_TXCAN0)
unnamed: PP1.1, U1.4 (MISO1_PWM0_KWP0_PP0)
unnamed: PP1.2, U1.3 (MOSI1_PWM1_KWP1_PP1)
unnamed: PP1.3, U1.2 (SCK1_PWM2_KWP2_PP2)
unnamed: PP1.4, U1.1 (/SS1_PWM3_KWP3_PP3)
unnamed: PP2.1, U1.112 (PP4_KWP4_PWM4_MISO2)
unnamed: PP2.2, U1.111 (PP5_KPW5_PWM5_MOSI2)
unnamed: PP2.3, U1.110 (PP6_KWP6_PWM6_/SS2)
unnamed: PP2.4, U1.109 (PP7_KWP7_PWM7_SCK2)
unnamed: R1.1, U1.36 (/XCLK_PE7)
unnamed: R2.1, U1.37 (MODB_PE6)
unnamed: R3.1, U1.38 (MODA_PE5)
unnamed: R78.1, U1.63 (PA6)
O2-Signal: U1.73 (PAD03_AN03)
PK5: U1.19 (PK5)
RESET: C6.1, P27.4, R5.1, U1.42 (/RESET)
RPM0: U1.9 (IOC0_PT0)
RPM1: U1.10 (IOC1_PT1)
RX: P59.2 (PM), U1.89 (PS0_RXD0)
SPR-Signal: U1.81 (PAD07_AN07)
TPS-Signal: U1.71 (PAD02_AN02)
TX: P59.1, U1.90 (PS1_TXD0)
VDDPLL: C7.2, C8.2, C9.2, U1.43 (VDDPLL)
XFC: C9.1, R6.2, U1.44 (XFC)
XTAL: C11.2, U1.47 (XTAL), Y1.2

Notes on the sheet:
CPU Pin 45
CPU Pin 44
CPU Pin 43
PP1 and PP2 allow us access to the Port P0-7 pins on the CPU so that we can test these outputs in the future.
Check Engine Light
C4 and C44 X7R Ceramic
C48 10v Tantalum C3 X7R Ceramic
C47 10v Tantalum C2 X7R Ceramic
Load/Run: Open = Run Closed = Load
C1 X7R Ceramic
C5 X7R Ceramic
XCLK
MODB
MODA
Crystal Circuit
PLL Circuit
BDM Connector
