HotCat/Jaguar/pcb/ft232.sch

## KiCad design pcb/ft232.sch (2013-09-18)

Schematic: ft232.sch

Parts:
C39, C41: 0.1uF
C40: 4.7uF
D33, D34: LED
J1: USB_B-MICRO
L1: 40
R55: 2.4k
R57, R58: 470
U7: FT232RL
U8: ADUMX201

Notes on the sheet:
R55 is Optional populate if needed
USB-B Micro Connector
Jumpers JP3 and JP4 are crossover wires to allow routing on the PCB. If you redesign the board remove these before trying to place the components on the PCB as you my not need them.
