HotCat/Jaguar/pcb/inputs.sch

## KiCad design pcb/inputs.sch (2013-09-18)

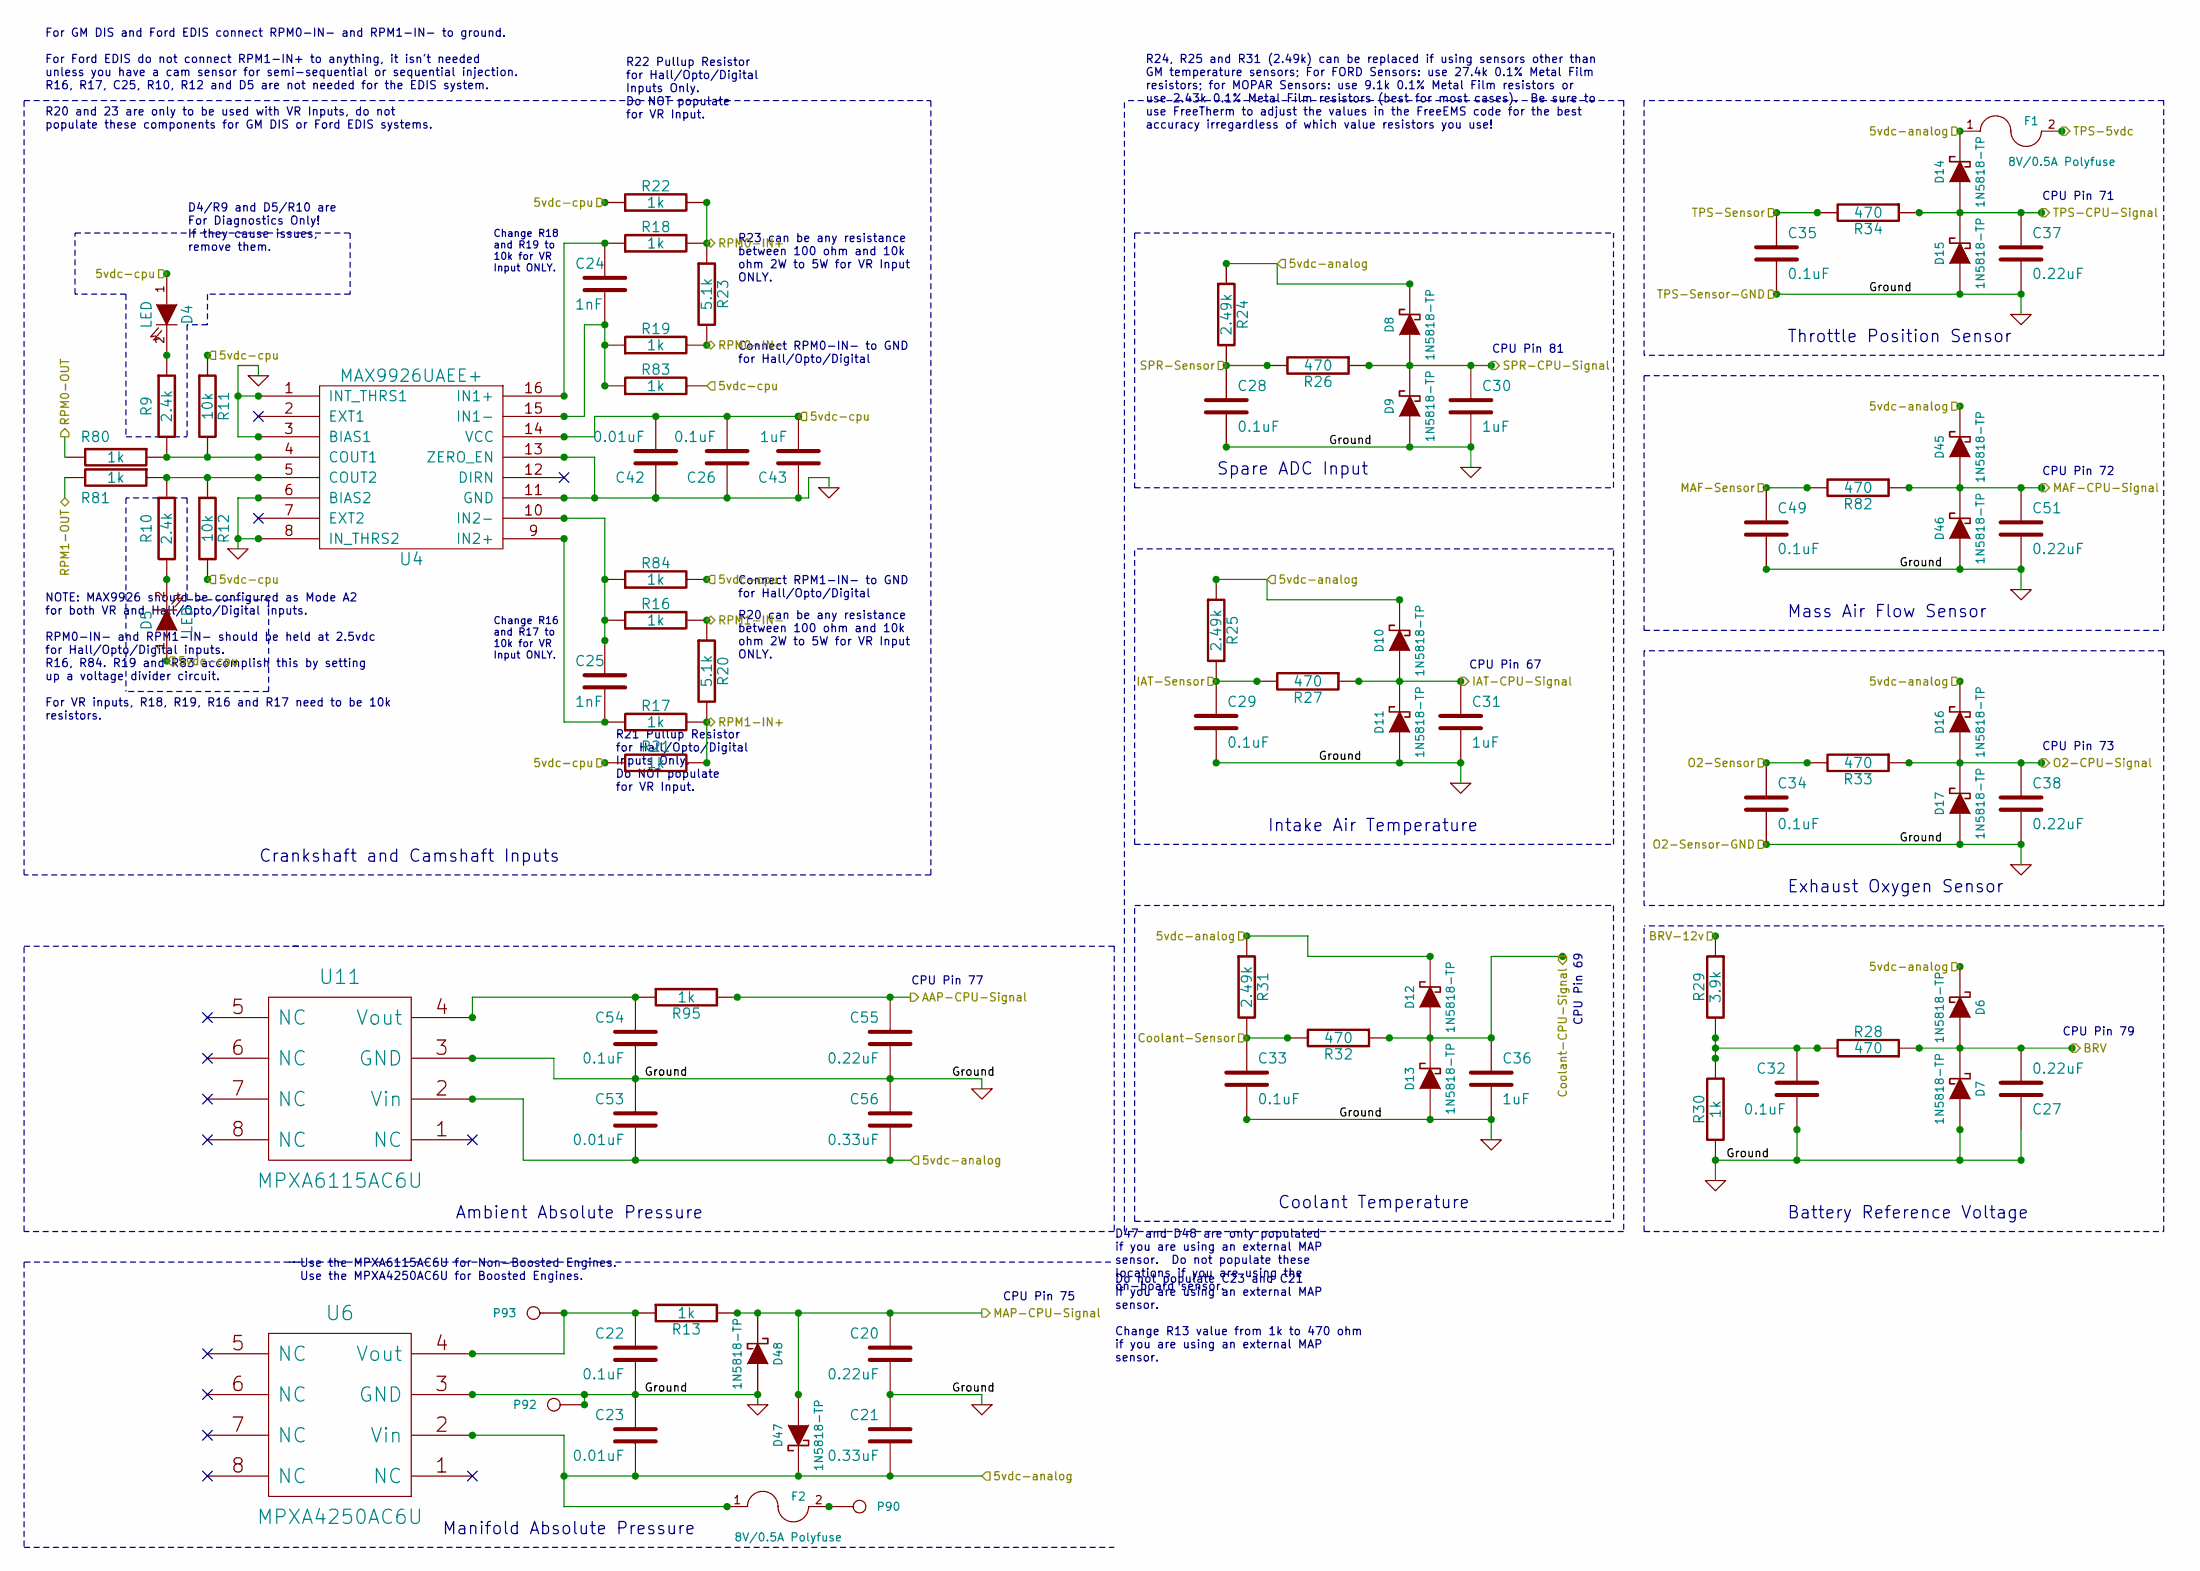
[picture p21: schematic inputs.sch]

Parts:
C20, C27, C37, C38, C51, C55: 0.22uF
C21, C56: 0.33uF
C22, C26, C28, C29, C32, C33, C34, C35, C49, C54: 0.1uF
C23, C42, C53: 0.01uF
C24, C25: 1nF
C30, C31, C36, C43: 1uF
D4, D5: LED
D6, D7, D8, D9, D10, D11, D12, D13, D14, D15, D16, D17, D45, D46, D47, D48: 1N5818-TP
F1, F2: 8V/0.5A Polyfuse
P90: 5v
P92: GND
P93: MAP
R9, R10: 2.4k
R11, R12: 10k
R13, R16, R17, R18, R19, R21, R22, R30, R80, R81, R83, R84, R95: 1k
R20, R23: 5.1k
R24, R25, R31: 2.49k
R26, R27, R28, R32, R33, R34, R82: 470
R29: 3.9k
U4: MAX9926UAEE+
U6: MPXA4250AC6U
U11: MPXA6115AC6U

Connections:
5vdc-analog: C21.2, C23.2, C53.2, C56.2, D6.2 (K), D8.2 (K), D10.2 (K), D12.2 (K), D14.2 (K), D16.2 (K), D45.2 (K), D47.2 (K), F1.1, F2.1, R24.1, R25.1, R31.1, U6.2 (Vin), U11.2 (Vin)
5vdc-cpu: C26.2, C42.2, C43.2, D4.1 (A), D5.1 (A), R11.1, R12.2, R21.1, R22.1, R83.2, R84.2, U4.14 (VCC)
AAP-CPU-Signal: C55.1, R95.2
BRV: C27.2, D6.1 (A), D7.2 (K), R28.1
BRV-12v: R29.1
Coolant-CPU-Signal: C36.1, D12.1 (A), D13.2 (K), R32.1
Coolant-Sensor: C33.1, R31.2, R32.2
GND: C20.2, C21.1, C22.2, C23.1, C26.1, C27.1, C28.2, C29.2, C30.2, C31.2, C32.2, C33.2, C34.2, C35.2, C36.2, C37.2, C38.2, C42.1, C43.1, C49.2, C51.2, C53.1, C54.2, C55.2, C56.1, D7.1 (A), D9.1 (A), D11.1 (A), D13.1 (A), D15.1 (A), D17.1 (A), D46.1 (A), D48.1 (A), P92.1, R30.2, U4.1 (INT_THRS1), U4.3 (BIAS1), U4.6 (BIAS2), U4.8 (IN_THRS2), U4.11 (GND), U4.13 (ZERO_EN), U6.3 (GND), U11.3 (GND)
IAT-CPU-Signal: C31.1, D10.1 (A), D11.2 (K), R27.1
IAT-Sensor: C29.1, R25.2, R27.2
MAF-CPU-Signal: C51.1, D45.1 (A), D46.2 (K), R82.1
MAF-Sensor: C49.1, R82.2
MAP-CPU-Signal: C20.1, D47.1 (A), D48.2 (K), R13.2
unnamed: C22.1, P93.1, R13.1, U6.4 (Vout)
unnamed: C24.1, R18.1, U4.16 (IN1+)
unnamed: C24.2, R19.1, R83.1, U4.15 (IN1-)
unnamed: C25.1, R16.1, R84.1, U4.10 (IN2-)
unnamed: C25.2, R17.1, U4.9 (IN2+)
unnamed: C32.1, R28.2, R29.2, R30.1
unnamed: C54.1, R95.1, U11.4 (Vout)
unnamed: D4.2 (K), R9.1
unnamed: D5.2 (K), R10.2
unnamed: F2.2, P90.1
unnamed: R10.1, R12.1, R81.1, U4.5 (COUT2)
unnamed: R9.2, R11.2, R80.1, U4.4 (COUT1)
O2-CPU-Signal: C38.1, D16.1 (A), D17.2 (K), R33.1
O2-Sensor: C34.1, R33.2
RPM0-IN+: R18.2, R22.2, R23.1
RPM0-IN-: R19.2, R23.2
RPM0-OUT: R80.2
RPM1-IN+: R17.2, R20.2, R21.2
RPM1-IN-: R16.2, R20.1
RPM1-OUT: R81.2
SPR-CPU-Signal: C30.1, D8.1 (A), D9.2 (K), R26.1
SPR-Sensor: C28.1, R24.2, R26.2
TPS-5vdc: F1.2
TPS-CPU-Signal: C37.1, D14.1 (A), D15.2 (K), R34.1
TPS-Sensor: C35.1, R34.2

Notes on the sheet:
Ambient Absolute Pressure
CPU Pin 77
Change R18 and R19 to 10k for VR Input ONLY.
Connect RPM0-IN- to GND for Hall/Opto/Digital
Do not populate C23 and C21 if you are using an external MAP sensor. Change R13 value from 1k to 470 ohm if you are using an external MAP sensor.
D47 and D48 are only populated if you are using an external MAP sensor. Do not populate these locations if you are using the on-board sensor.
Change R16 and R17 to 10k for VR Input ONLY.
Exhaust Oxygen Sensor
CPU Pin 73
Use the MPXA6115AC6U for Non-Boosted Engines. Use the MPXA4250AC6U for Boosted Engines.
R24, R25 and R31 (2.49k) can be replaced if using sensors other than GM temperature sensors; For FORD Sensors: use 27.4k 0.1% Metal Film resistors; for MOPAR Sensors: use 9.1k 0.1% Metal Film resistors or use 2.43k 0.1% Metal Film resistors (best for most cases). Be sure to use FreeTherm to adjust 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
For GM DIS and Ford EDIS connect RPM0-IN- and RPM1-IN- to ground. For Ford EDIS do not connect RPM1-IN+ to anything, it isn't needed unless you have a cam sensor for semi-sequential or sequential injection. R16, R17, C25, R10, R12 and D5 are not needed for the EDIS system. R20 and 23 are only to be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
D4/R9 and D5/R10 are For Diagnostics Only! If they cause issues, remove them.
R20 can be any resistance between 100 ohm and 10k ohm 2W to 5W for VR Input ONLY.
R23 can be any resistance between 100 ohm and 10k ohm 2W to 5W for VR Input ONLY.
NOTE: MAX9926 should be configured as Mode A2 for both VR and Hall/Opto/Digital inputs. RPM0-IN- and RPM1-IN- should be held at 2.5vdc for Hall/Opto/Digital inputs. R16, R84. R19 and R83 accomplish this by setting up a voltage divider circuit. For VR inputs, R18, R19, R16 and R17 need to be 10k res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
Connect RPM1-IN- to GND for Hall/Opto/Digital
R21 Pullup Resistor for Hall/Opto/Digital Inputs Only. Do NOT populate for VR Input.
R22 Pullup Resistor for Hall/Opto/Digital Inputs Only. Do NOT populate for VR Input.
Crankshaft and Camshaft Inputs
CPU Pin 75
CPU Pin 72
CPU Pin 69
CPU Pin 67
CPU Pin 71
CPU Pin 81
CPU Pin 79
Coolant Temperature
Mass Air Flow Sensor
Intake Air Temperature
Throttle Position Sensor
Spare ADC Input
Manifold Absolute Pressure
Battery Reference Voltage
