HotCat/Jaguar/(commit log)

2013-09-16 Changed ground connection between Q1/Q2 and Q3/Q4 to 0 ohm SMD-1206 jumpers.
    [Injectors.sch, Jaguar.brd, Jaguar.ods, Jaguar.sch, Outputs.sch, PowerSupplies.sch, cpu.sch, ft232.sch]
2013-09-16 Added screenshot of MOSFET ground jumper idea: docs/MOSFET-GND-Idea.png
2013-09-16 Modified ground jumpers to be 7 jumpers size SMD 2512.
    [Injectors.sch, Jaguar.brd, Jaguar.ods, Jaguar.sch, Outputs.sch, PowerSupplies.sch, cpu.sch, ft232.sch]
2013-09-17 Rotated ground jumpers 90 degrees and shortened the traces.
    [Injectors.sch, Jaguar.brd, Jaguar.sch, Outputs.sch, PowerSupplies.sch, cpu.sch, ft232.sch, inputs.sch]
2013-09-17 Moved jumper pads closer together.
    [Jaguar.brd]
2013-09-18 Made SMD r_2512 pads smaller.
    [Jaguar.brd]
2013-09-18 Moved pads under SMD R_2512 component by 0.010", all traces to pads are straight except last pad.
    [Injectors.sch, Jaguar.brd, Jaguar.sch, Outputs.sch, PowerSupplies.sch, cpu.sch, ft232.sch, inputs.sch]
2013-09-18 Changed last jumper trace to exit the bottom of the SMD pad then turn towards the through hole pad.
    [Jaguar.brd]
2013-09-18 Filled in ground plain and ran DRC.
    [Jaguar.brd]
2013-09-18 Updated git hash on PCB and Schematic to 0d4743b8df.
    [Injectors.sch, Jaguar.brd, Jaguar.sch, Outputs.sch, PowerSupplies.sch, cpu.sch, ft232.sch, inputs.sch]
2013-09-18 Removed 0.4/0.5-alpha Gerber files in preparation of a new release.
    [Jaguar.drl, Jaguar.gbl, Jaguar.gbo, Jaguar.gbr, Jaguar.gbs, Jaguar.gtl, Jaguar.gto, Jaguar.gts]
2013-09-18 Updated PDF files and PNG images of the PCB.
